min-lfl/Ping_Hen/PROJECT_INTRO.md

# 项目简介

项目地址：[github.com/min-lfl/Ping_Hen](https://github.com/min-lfl/Ping_Hen)

## 推荐版本（简历 / 作品集）

独立设计并实现了一套基于 STM32F103C8T6 的球杆平衡控制系统，完整负责控制板设计、嵌入式软件开发、控制算法设计、参数整定和实物故障排查。系统使用 STP-23L 激光测距传感器获取小球位置，通过 10 Hz 位置外环与 100 Hz 速度内环组成串级 PID，驱动闭环步进电机实时调整球杆倾角，实现小球向目标位置回正并保持稳定。针对低频测距数据，设计了位置差分速度估算、低通滤波、异常值限幅和静止归零机制；通信层采用 UART DMA + IDLE 完成跨缓冲区数据帧解析、校验及错误重同步。同时加入积分限幅、过零清积分、控制死区、指令斜率限制和失效回水平等保护，并使用 OLED、Keil Watch 与 VOFA+ 完成参数观察和实物调试。目前系统已能够稳定运行，后续将继续补充量化测试和工程可靠性优化。

## GitHub About 短描述

基于 STM32F103 的球杆平衡控制系统：激光测距反馈、串级 PID、UART DMA + IDLE 通信与闭环步进电机控制。

## 简历精简版

独立完成基于 STM32F103 的球杆平衡系统，包括自制控制板、外设驱动、串级 PID、参数整定和故障排查。采用激光测距获取位置，以 10 Hz 位置外环和 100 Hz 速度内环驱动闭环步进电机；实现 DMA + IDLE 帧解析、速度估算、低通滤波、积分/输出限幅、指令斜率限制及异常回水平，并通过 OLED 和 VOFA+ 完成可视化调试。

## 面试口述版（约 40 秒）

这是我独立完成的一个球杆平衡项目，从控制板设计、焊接调试到 STM32 程序和参数整定都由我负责。系统通过激光传感器测量小球位置，我设计了位置外环和速度内环组成的串级 PID，再控制闭环步进电机改变杆的倾角。这个项目的难点是激光数据只有约 10 Hz，但速度环需要运行在 100 Hz，所以我实现了基于实际采样间隔的位置差分、低通滤波、尖峰限幅和超时归零。通信方面使用环形 DMA 加 IDLE 中断，并处理了跨缓冲区、校验失败和重新同步。早期我也尝试过 MPU6050 加速度补偿，但实物中存在状态不可观测的问题，之后通过分析原因改成激光位置闭环，最终实现了比较稳定的控制效果。

## 可用于简历的关键词

`STM32F103` · `C` · `HAL` · `串级 PID` · `定时器中断` · `UART DMA` · `IDLE` · `I2C` · `激光测距` · `速度估算` · `低通滤波` · `闭环步进电机` · `VOFA+` · `硬件调试`
