min-lfl/Ping_Hen/Core/Src/main.c

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
/* Includes ------------------------------------------------------------------*/
#include "main.h"
#include "dma.h"
#include "i2c.h"
#include "tim.h"
#include "usart.h"
#include "gpio.h"

/* USER CODE BEGIN Includes */
#include "ssd1306.h"
#include "ssd1306_fonts.h" // 包含字库
#include <stdio.h>         // 为了使用 sprintf 函数把数字转成字符串
#include "Printf_DMA.H"
#include "mpu6050.h"
#include "Emm_V5.h"
#include "BSP_Emm_V5.H"
#include "User_Task.H"
/* USER CODE END Includes */


void SystemClock_Config(void);
/**
  * @brief  The application entry point.
  * @retval int
  */
int main(void)
{

  /* MCU Configuration--------------------------------------------------------*/

  /* Reset of all peripherals, Initializes the Flash interface and the Systick. */
  HAL_Init();

  /* Configure the system clock */
  SystemClock_Config();

  /* Initialize all configured peripherals */
  MX_GPIO_Init();
  MX_DMA_Init();
  MX_I2C1_Init();
  MX_USART1_UART_Init();
  MX_I2C2_Init();
  MX_TIM1_Init();
  MX_TIM2_Init();
  MX_USART2_UART_Init();
  MX_TIM3_Init();
  /* USER CODE BEGIN 2 */
	User_Task_Init(); //初始化任务模块,包括陀螺仪模块和按键模块
	
	//#######初始化之后才可以开启中断#############
	HAL_TIM_Base_Start_IT(&htim1);	//定时器初始化
	HAL_TIM_Base_Start_IT(&htim2);	//定时器初始化
	HAL_TIM_Base_Start_IT(&htim3);	//定时器初始化
	
	//翻转电平表示初始化成功
	HAL_GPIO_TogglePin(GPIOB, GPIO_PIN_12);
	
  /* USER CODE END 2 */

  /* Infinite loop */
  /* USER CODE BEGIN WHILE */
	while (1)
	{
		User_Task_Param_Update();		//执行参数更新任务
		User_Task_OLED_Update();  	//执行OLED任务,用于更新OLED屏幕显示
    User_Task_UART_Update();  //执行串口任务,用于更新串口数据传输
		User_Task_key();  					//执行按键任务,按键任务目前包括,扫描三个按键,发送翻转对应LED灯以及电机位置模式正反转的功能
		HAL_Delay(1);
    /* USER CODE END WHILE */

    /* USER CODE BEGIN 3 */
  }
  /* USER CODE END 3 */
}

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
/* USER CODE BEGIN 4 */
void HAL_TIM_PeriodElapsedCallback(TIM_HandleTypeDef *htim)
{
	//频率300hz
	if (htim->Instance == TIM1) {
//		User_Task_MPU6050_Update();	//执行陀螺仪任务,用于采样陀螺仪,一定要记得根据实际采样频率设置内部
	}
	
	//频率100hz,内环速度环
	if (htim->Instance == TIM2) {
			User_Task_Speed_Control();     // 在 BALL_CONTROL_SPEED_LOOP_HZ 对应的固定频率定时中断中调用。
	}
	
	//频率10hz,外环位置环
	if (htim->Instance == TIM3) {
			User_Task_Position_Control();  // 在 BALL_CONTROL_POSITION_LOOP_HZ 对应的固定频率定时中断中调用。
	}
}
/* USER CODE END 4 */
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
