min-lfl/Ping_Hen/(commit log)

2026-08-17 完成git仓库建立,目前屏幕移植正常
2026-08-18 陀螺仪可以读取数据了
2026-08-18 准备叫codex修改
2026-08-18 优化了陀螺仪漂移,现在静止状态可以做到0.15°误差
2026-08-18 陀螺仪大功告成,完成了精度优化
2026-08-25 刚完成电机绝对位置正反转函数,准备开始封装成任务
2026-08-25 完成了任务的封装,各模块解耦的很好,陀螺仪正常读取
2026-08-26 加速度环闭环,但是现在非常难调
2026-08-26 解决了大部分问题但是还不稳定的系统
2026-08-27 平衡杆加速度补偿框架写好,剩调参
2026-08-27 基本上可以控制惯性的参数
2026-08-27 最后调一次的参数
2026-08-28 准备移植串口激光
2026-08-29 准备开始写速度环加位置环的控制方案2
2026-08-30 速度环初步参数,可以消除速度,但是要多次摆动后才消除
2026-08-30 已经可以维持0点附近了,重大突破
2026-08-30 比较合适的参数,已经几乎可以瞬间到达0点.接下来需要引入加速度做前馈控制
2026-08-30 微调参数第二版,细调需要用vofa+上位机了,准备写上位机的发送程序
2026-08-30 完成串口vofa+的测试代码,demo跑起来了
2026-09-01 完成了基本的上位机收发,可以显示数据波形
2026-09-02 增加了过0点清除积分逻辑,现在不会有超调量存在
2026-09-04 完成了比较丝滑的控制,各项参数均为较优,下面需要加入加速度补偿操作
2026-09-04 增加了md说明文档
2026-10-01 修改部分说明文档
